FaWald/Project-Voxel/README.md

# Project-Voxel
Some HW &amp; SW Project bundle under this name
