FaWald/Project-Voxel/Modules/Eth2UsbC/BOM.txt

| Type | Name | LCSC Number  | Price (€)  |
|---|---|---|---|
| LAN | CKMTW R-RJ45R08P-C000 | C386757 | 0.3467 |
| ETH-Chip  | REALTEK RTL8153B-VB-CG | C2802072 | 3.1395	 |
