FaWald/Project-Voxel/Modules/Eth2UsbC/Eth2UsbC.kicad_pcb

## KiCad design misc/01_cn_remo_connector.kicad_sch

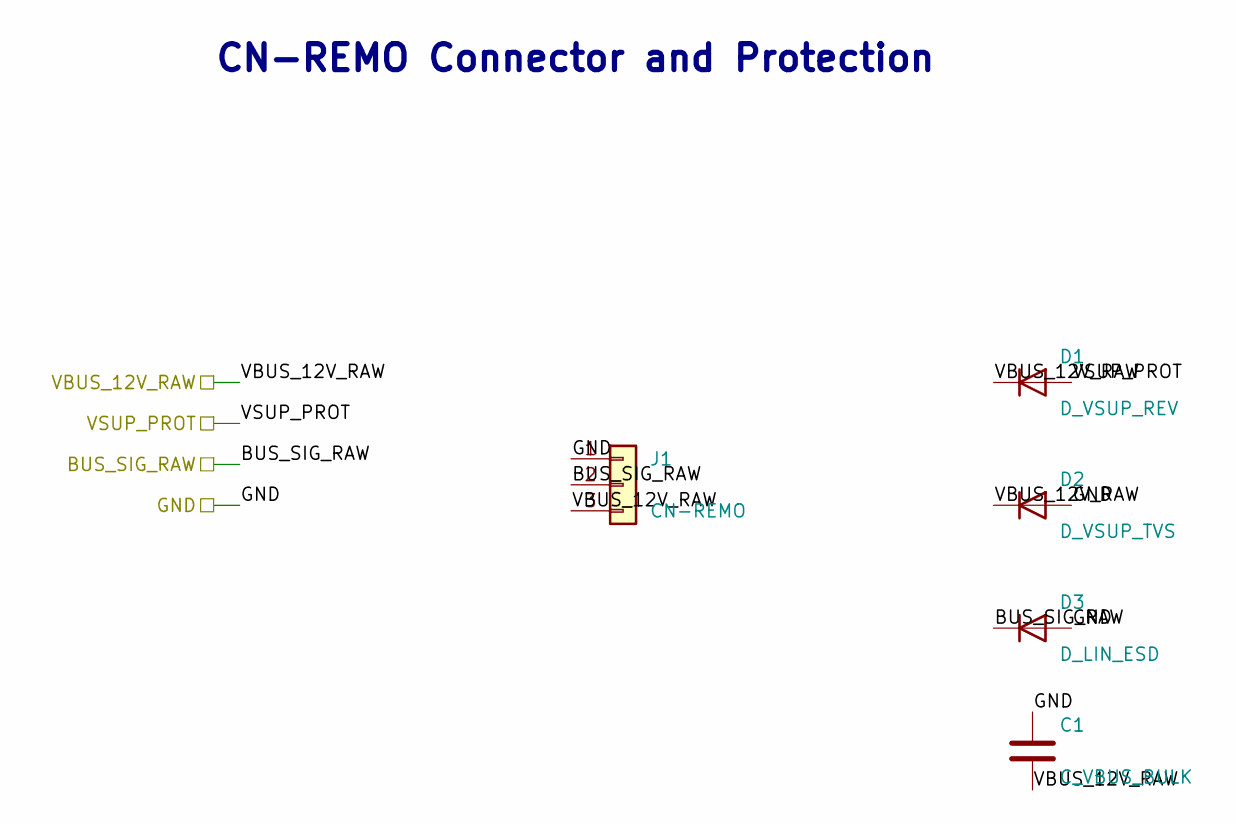
[picture p1: schematic 01_cn_remo_connector.kicad_sch]

Parts:
C1: C_VBUS_BULK
D1: D_VSUP_REV
D2: D_VSUP_TVS
D3: D_LIN_ESD
J1: CN-REMO

Connections:
BUS_SIG_RAW: D3.1 (K), J1.2
GND: C1.1, D2.2 (A), D3.2 (A), J1.1
VBUS_12V_RAW: C1.2, D1.1 (K), D2.1 (K), J1.3
VSUP_PROT: D1.2 (A)

Notes on the sheet:
CN-REMO Connector and Protection
