FaWald/Project-Voxel/Modules/Eth2UsbC/Eth2UsbC.kicad_pcb

## KiCad design misc/02_tlin14313_lin_sbc.kicad_sch

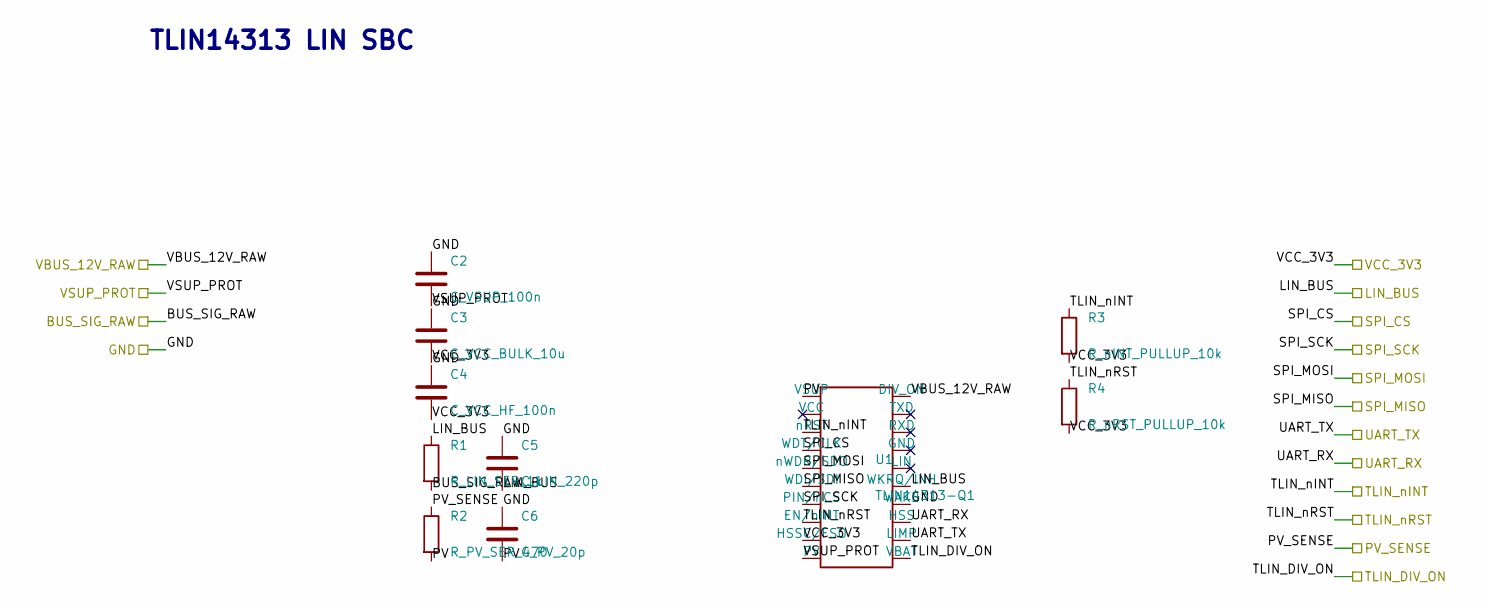
[picture p2: schematic 02_tlin14313_lin_sbc.kicad_sch]

Parts:
C2: C_VSUP_100n
C3: C_VCC_BULK_10u
C4: C_VCC_HF_100n
C5: C_LIN_220p
C6: C_PV_20p
R1: R_LIN_SER_1k
R2: R_PV_SER_470
R3: R_nINT_PULLUP_10k
R4: R_nRST_PULLUP_10k
U1: TLIN14313-Q1

Connections:
BUS_SIG_RAW: R1.2
GND: C2.1, C3.1, C4.1, C5.1, C6.1, U1.17 (WAKE)
LIN_BUS: C5.2, R1.1, U1.16 (WKRQ/INH)
PV: C6.2, R2.2, U1.1 (VSUP)
PV_SENSE: R2.1
SPI_CS: U1.4 (WDT/CLK)
SPI_MISO: U1.6 (WDI/SDI)
SPI_MOSI: U1.5 (nWDR/SDO)
SPI_SCK: U1.7 (PIN/nCS)
TLIN_DIV_ON: U1.20 (VBAT)
TLIN_nINT: R3.1, U1.3 (nRST)
TLIN_nRST: R4.1, U1.8 (EN/nINT)
UART_RX: U1.18 (HSS)
UART_TX: U1.19 (LIMP)
VBUS_12V_RAW: U1.11 (DIV_ON)
VCC_3V3: C3.2, C4.2, R3.2, R4.2, U1.9 (HSSC/FSO)
VSUP_PROT: C2.2, U1.10 (PV)

Notes on the sheet:
TLIN14313 LIN SBC
