FaWald/Project-Voxel/Modules/Eth2UsbC/Eth2UsbC.kicad_pcb

## KiCad design misc/03_nrf54l10_power_reset_clocks.kicad_sch

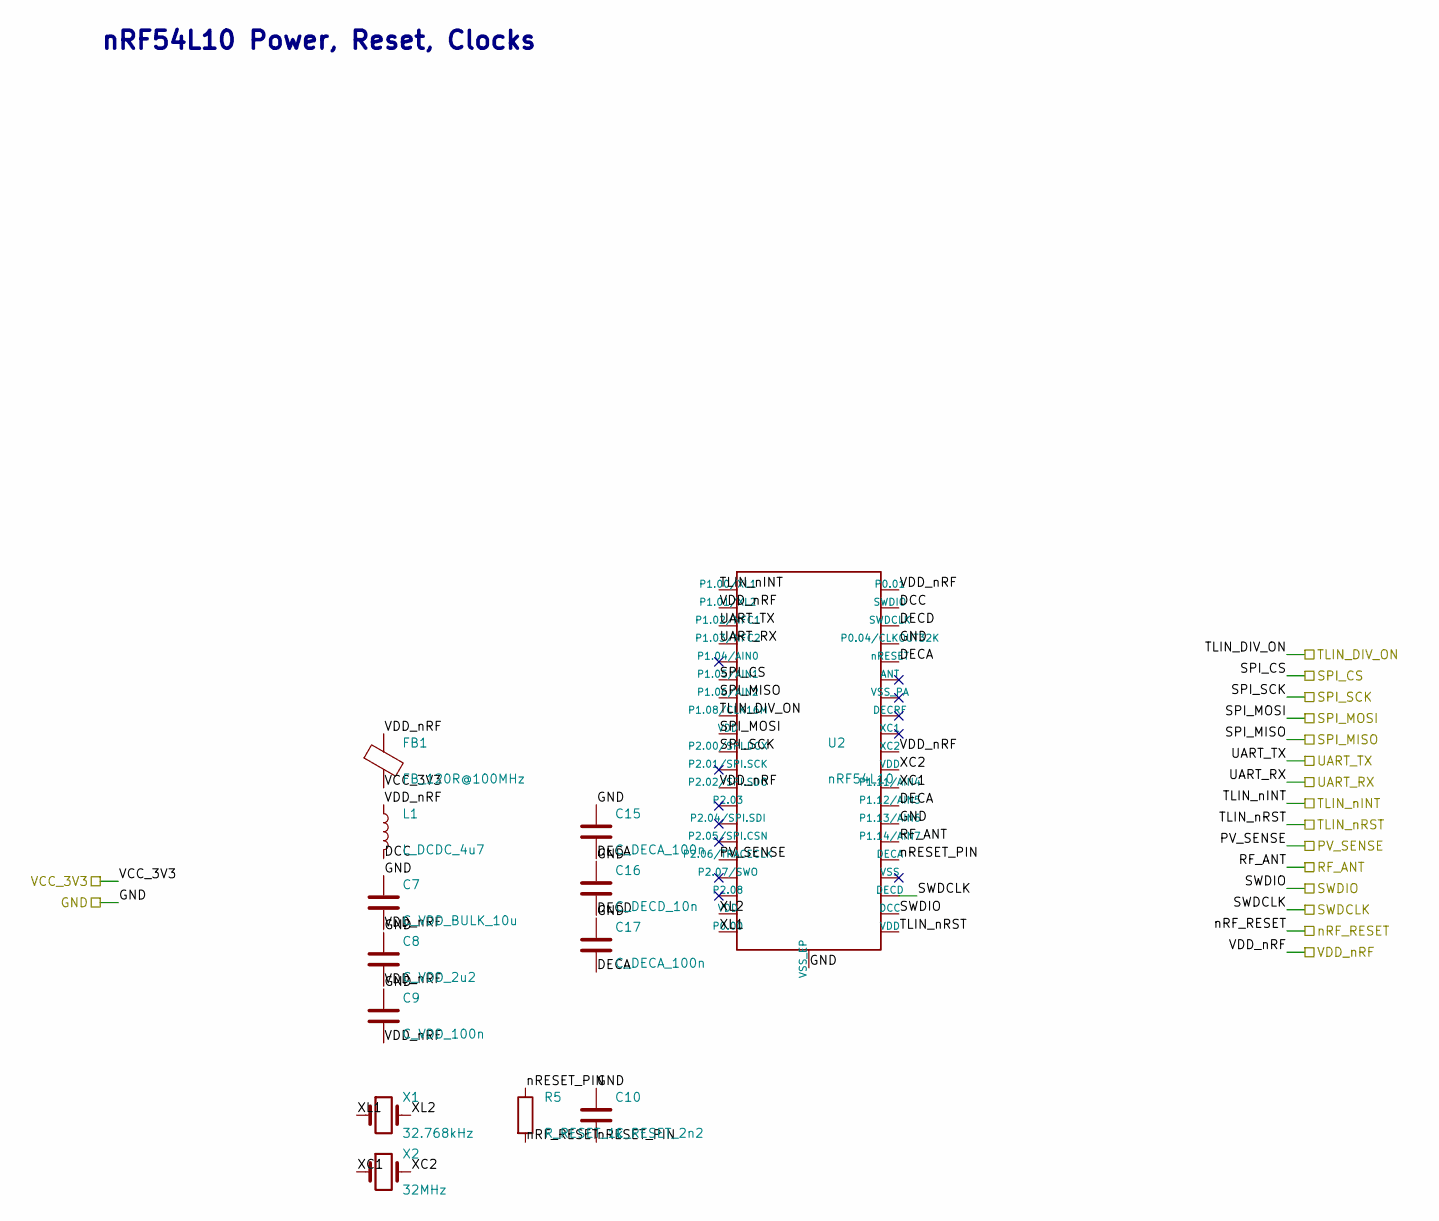
[picture p3: schematic 03_nrf54l10_power_reset_clocks.kicad_sch]

Parts:
C7: C_VDD_BULK_10u
C8: C_VDD_2u2
C9: C_VDD_100n
C10: C_RESET_2n2
C15, C17: C_DECA_100n
C16: C_DECD_10n
FB1: FB_120R@100MHz
L1: L_DCDC_4u7
R5: R_RESET_1k
U2: nRF54L10
X1: 32.768kHz
X2: 32MHz

Connections:
DCC: L1.2, U2.22 (SWDIO)
DECA: C15.2, C17.2, U2.25 (nRESET), U2.33 (P1.12/AIN5)
DECD: C16.2, U2.23 (SWDCLK)
GND: C7.1, C8.1, C9.1, C10.1, C15.1, C16.1, C17.1, U2.24 (P0.04/CLKOUT32K), U2.34 (P1.13/AIN6), U2.41 (VSS_EP)
PV_SENSE: U2.16 (P2.06/TRACECLK)
RF_ANT: U2.35 (P1.14/AIN7)
SPI_CS: U2.6 (P1.05/AIN1)
SPI_MISO: U2.7 (P1.06/AIN2)
SPI_MOSI: U2.9 (VDD)
SPI_SCK: U2.10 (P2.00/SPI.DCX)
SWDCLK: U2.38 (DECD)
SWDIO: U2.39 (DCC)
TLIN_DIV_ON: U2.8 (P1.08/CLK16M)
TLIN_nINT: U2.1 (P1.00/XL1)
TLIN_nRST: U2.40 (VDD)
UART_RX: U2.4 (P1.03/NFC2)
UART_TX: U2.3 (P1.02/NFC1)
VCC_3V3: FB1.2
VDD_nRF: C7.2, C8.2, C9.2, FB1.1, L1.1, U2.2 (P1.01/XL2), U2.12 (P2.02/SPI.SDO), U2.21 (P0.01), U2.30 (XC2)
XC1: U2.32 (P1.11/AIN4), X2.1
XC2: U2.31 (VDD), X2.2
XL1: U2.20 (P0.00), X1.1
XL2: U2.19 (VDD), X1.2
nRESET_PIN: C10.2, R5.1, U2.36 (DECA)
nRF_RESET: R5.2

Notes on the sheet:
nRF54L10 Power, Reset, Clocks
