FaWald/Project-Voxel/Modules/Eth2UsbC/Eth2UsbC.kicad_pcb

## KiCad design misc/04_rf_antenna.kicad_sch

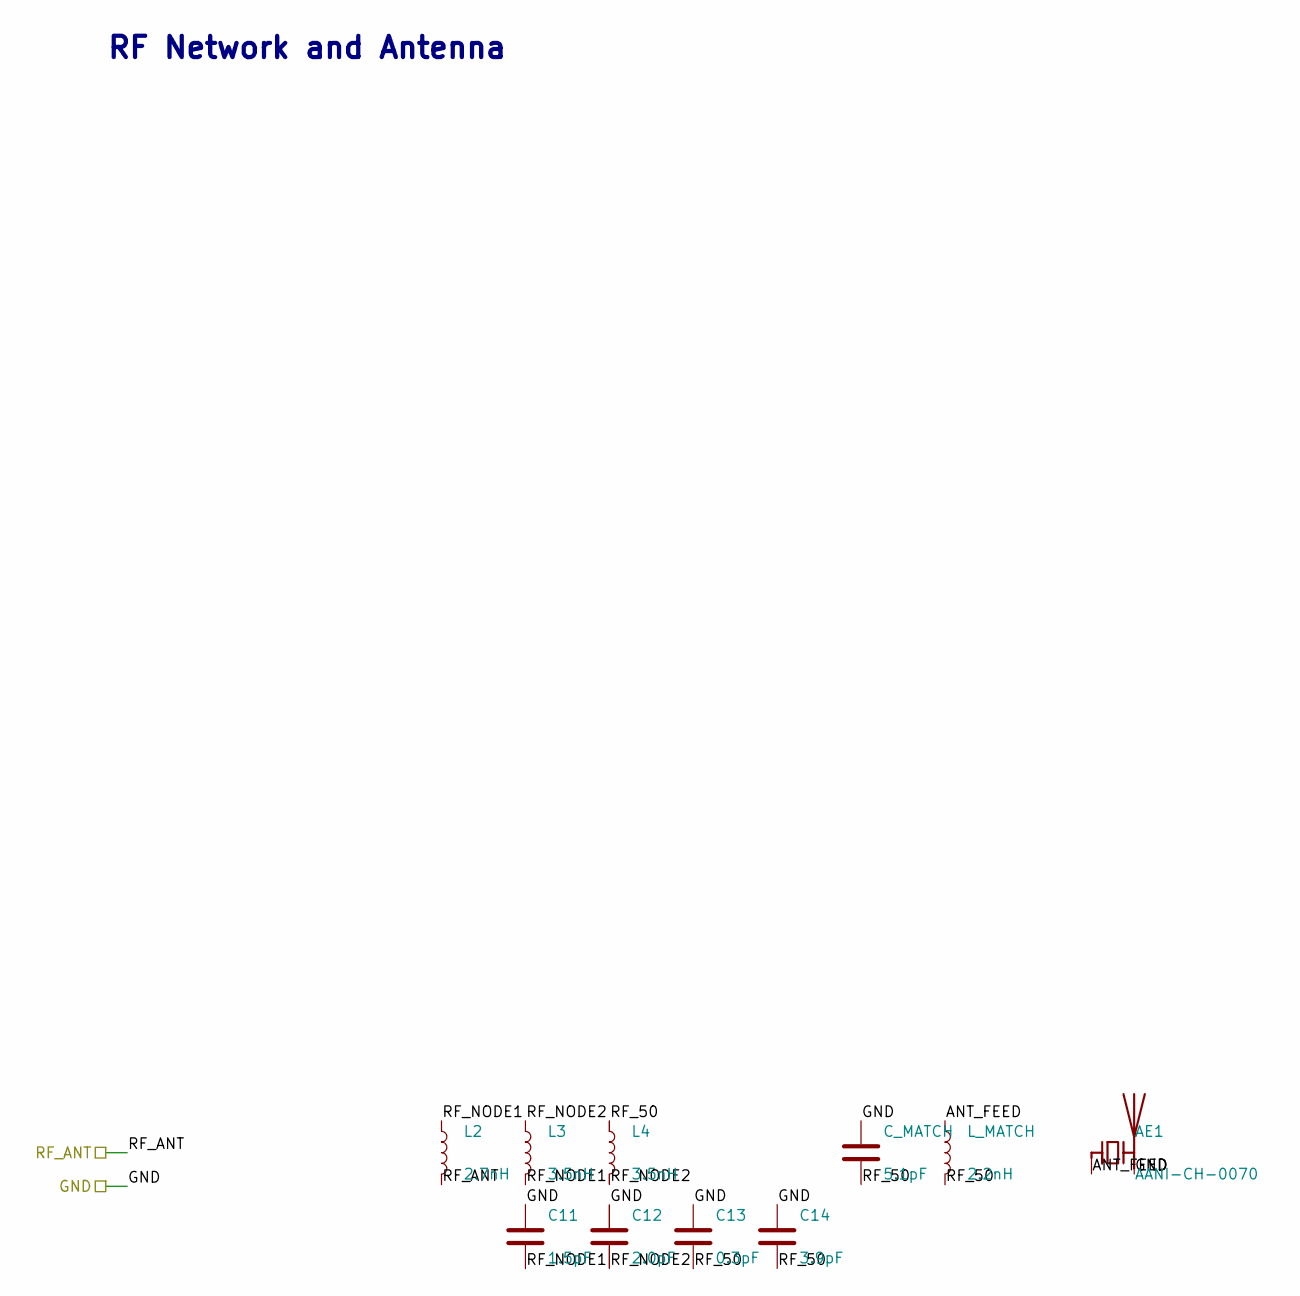
[picture p4: schematic 04_rf_antenna.kicad_sch]

Parts:
AE1: AANI-CH-0070
C11: 1.5pF
C12: 2.0pF
C13: 0.3pF
C14: 3.9pF
C_MATCH: 5.1pF
L2: 2.7nH
L3, L4: 3.5nH
L_MATCH: 2.2nH

Connections:
ANT_FEED: AE1.1 (FEED), L_MATCH.1
GND: AE1.2 (PCB_Trace), C11.1, C12.1, C13.1, C14.1, C_MATCH.1
RF_50: C13.2, C14.2, C_MATCH.2, L4.1, L_MATCH.2
RF_ANT: L2.2
RF_NODE1: C11.2, L2.1, L3.2
RF_NODE2: C12.2, L3.1, L4.2

Notes on the sheet:
RF Network and Antenna
