FaWald/Project-Voxel/Modules/Eth2UsbC/Eth2UsbC.kicad_pcb

## KiCad design misc/05_debug_test.kicad_sch

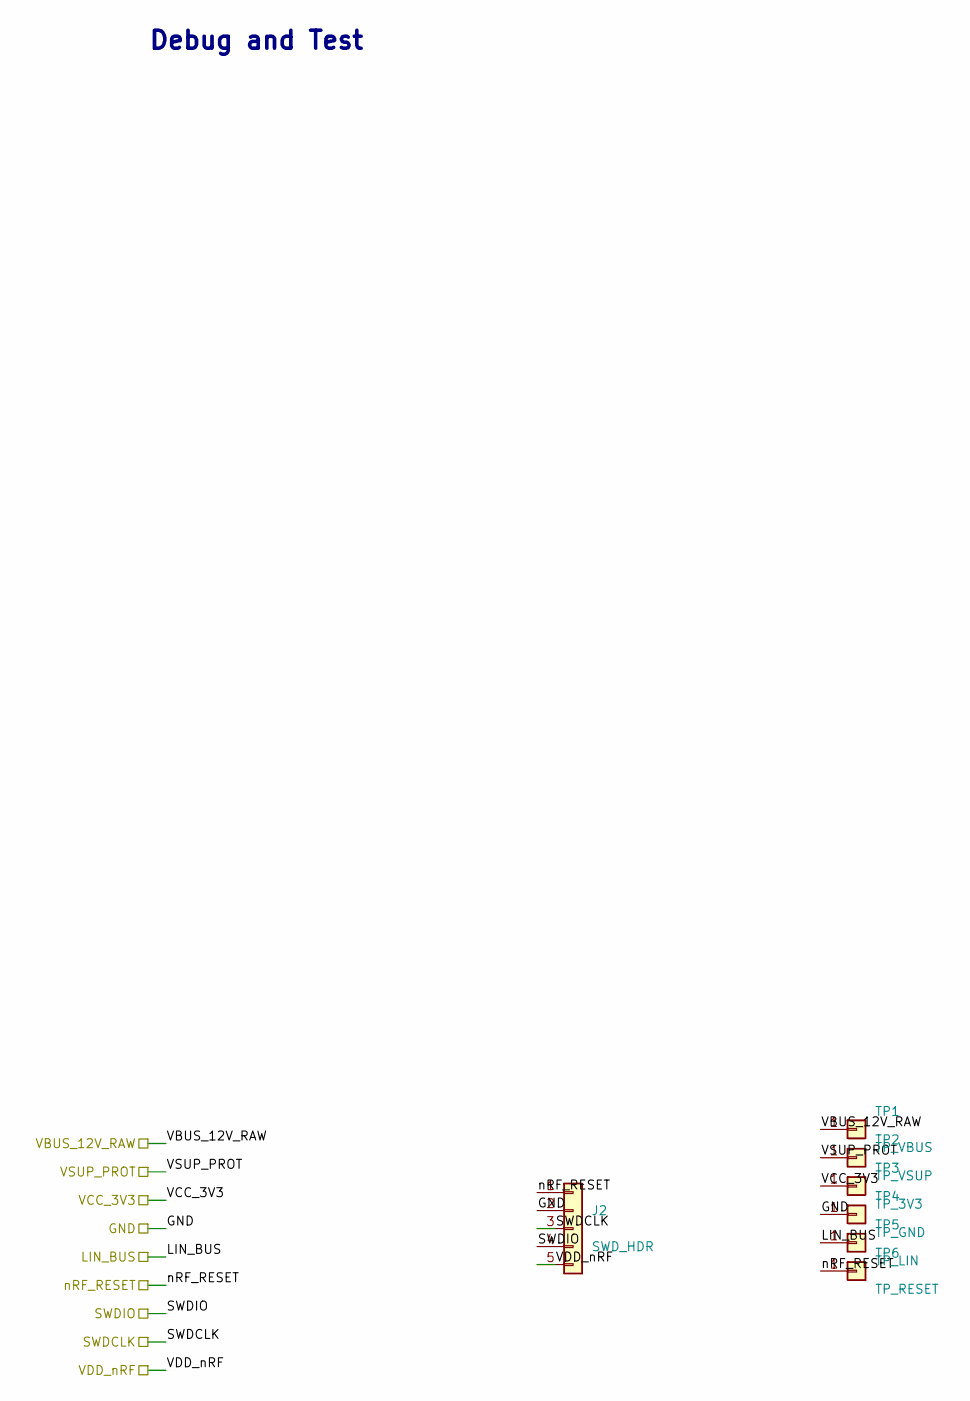
[picture p5: schematic 05_debug_test.kicad_sch]

Parts:
J2: SWD_HDR
TP1: TP_VBUS
TP2: TP_VSUP
TP3: TP_3V3
TP4: TP_GND
TP5: TP_LIN
TP6: TP_RESET

Connections:
GND: J2.2, TP4.1
LIN_BUS: TP5.1
SWDCLK: J2.3
SWDIO: J2.4
VBUS_12V_RAW: TP1.1
VCC_3V3: TP3.1
VDD_nRF: J2.5
VSUP_PROT: TP2.1
nRF_RESET: J2.1, TP6.1

Notes on the sheet:
Debug and Test
