FaWald/Project-Voxel/Modules/Eth2UsbC/Eth2UsbC.kicad_pcb

## KiCad design misc/backup.kicad_sch

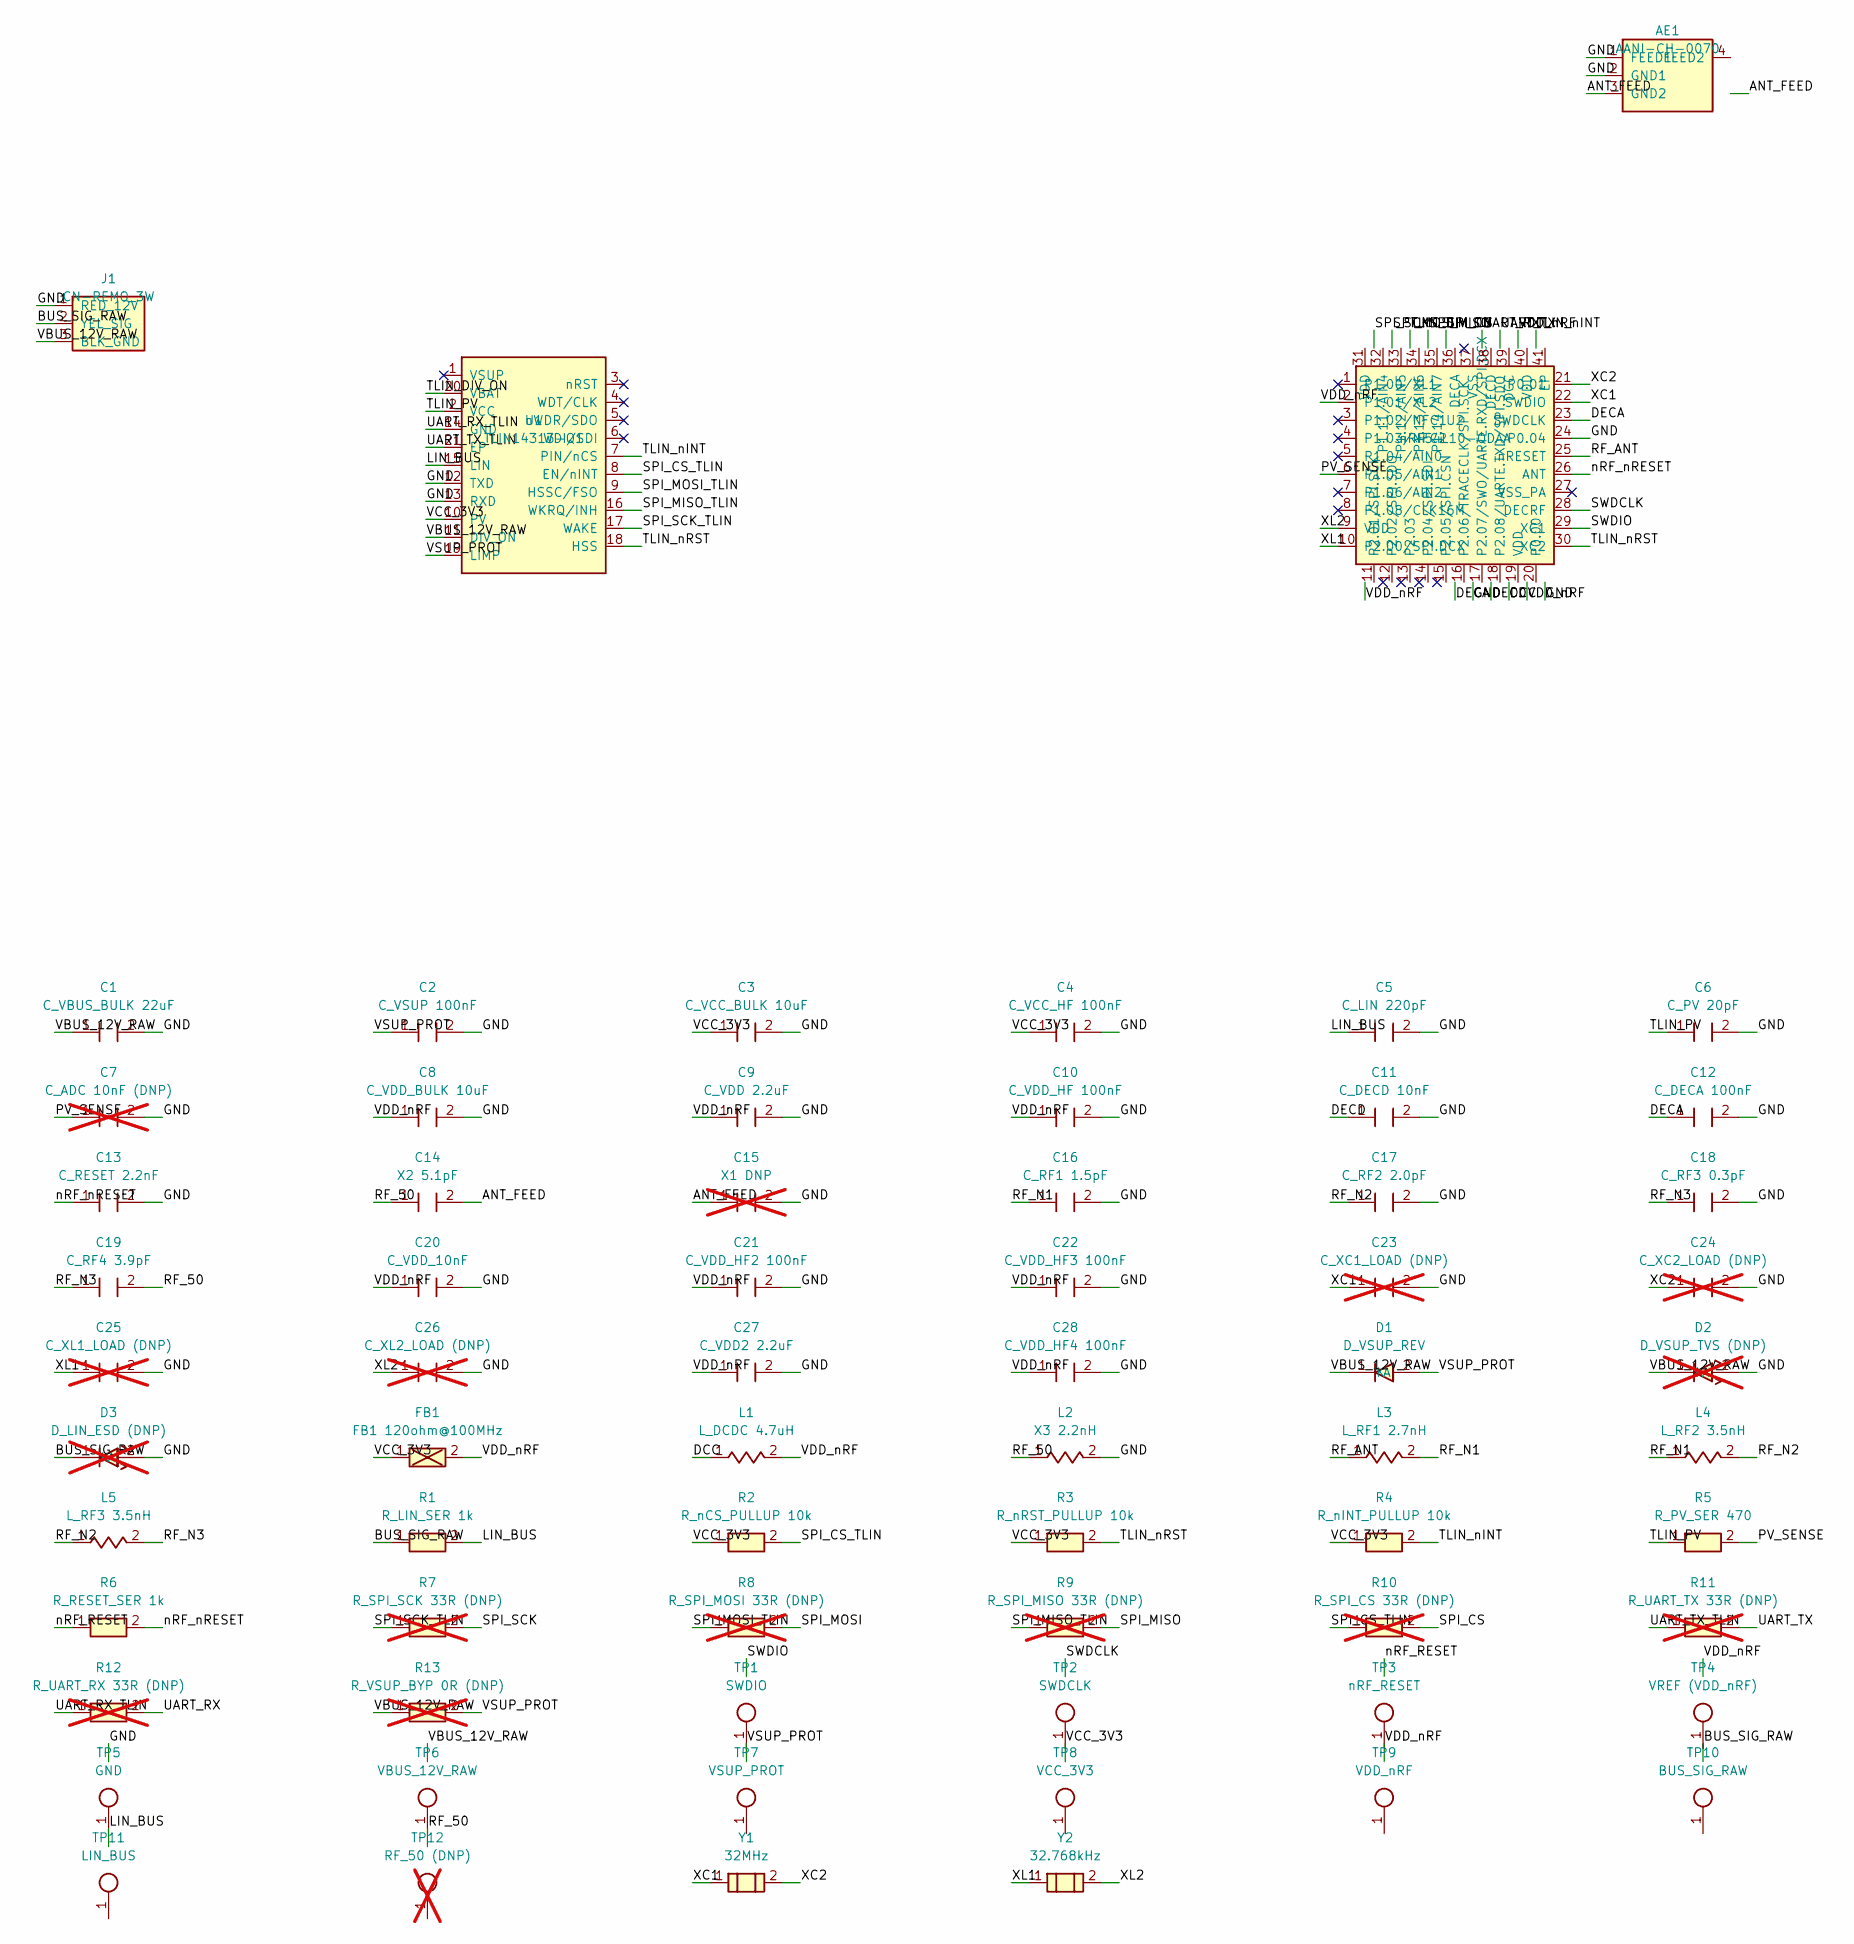
[picture p6: schematic backup.kicad_sch]

Parts:
AE1: AANI-CH-0070; Abracon_AANI-CH-0070
C1: C_VBUS_BULK 22uF; C_0805_2012Metric
C2: C_VSUP 100nF; C_0402_1005Metric
C3: C_VCC_BULK 10uF; C_0603_1608Metric
C4: C_VCC_HF 100nF; C_0402_1005Metric
C5: C_LIN 220pF; C_0402_1005Metric
C6: C_PV 20pF; C_0402_1005Metric
C7: C_ADC 10nF (DNP); C_0402_1005Metric; not fitted
C8: C_VDD_BULK 10uF; C_0603_1608Metric
C9: C_VDD 2.2uF; C_0402_1005Metric
C10: C_VDD_HF 100nF; C_0402_1005Metric
C11: C_DECD 10nF; C_0402_1005Metric
C12: C_DECA 100nF; C_0402_1005Metric
C13: C_RESET 2.2nF; C_0402_1005Metric
C14: X2 5.1pF; C_0402_1005Metric
C15: X1 DNP; C_0402_1005Metric; not fitted
C16: C_RF1 1.5pF; C_0402_1005Metric
C17: C_RF2 2.0pF; C_0402_1005Metric
C18: C_RF3 0.3pF; C_0402_1005Metric
C19: C_RF4 3.9pF; C_0402_1005Metric
C20: C_VDD_10nF; C_0402_1005Metric
C21: C_VDD_HF2 100nF; C_0402_1005Metric
C22: C_VDD_HF3 100nF; C_0402_1005Metric
C23: C_XC1_LOAD (DNP); C_0402_1005Metric; not fitted
C24: C_XC2_LOAD (DNP); C_0402_1005Metric; not fitted
C25: C_XL1_LOAD (DNP); C_0402_1005Metric; not fitted
C26: C_XL2_LOAD (DNP); C_0402_1005Metric; not fitted
C27: C_VDD2 2.2uF; C_0402_1005Metric
C28: C_VDD_HF4 100nF; C_0402_1005Metric
D1: D_VSUP_REV; D_SMA
D2: D_VSUP_TVS (DNP); D_SMB; not fitted
D3: D_LIN_ESD (DNP); D_SOD-523; not fitted
FB1: FB1 120ohm@100MHz; Ferrite_Bead_0603_1608Metric
J1: CN-REMO_3W
L1: L_DCDC 4.7uH; L_0603_1608Metric
L2: X3 2.2nH; L_0402_1005Metric
L3: L_RF1 2.7nH; L_0402_1005Metric
L4: L_RF2 3.5nH; L_0402_1005Metric
L5: L_RF3 3.5nH; L_0402_1005Metric
R1: R_LIN_SER 1k; R_0402_1005Metric
R2: R_nCS_PULLUP 10k; R_0402_1005Metric
R3: R_nRST_PULLUP 10k; R_0402_1005Metric
R4: R_nINT_PULLUP 10k; R_0402_1005Metric
R5: R_PV_SER 470; R_0402_1005Metric
R6: R_RESET_SER 1k; R_0402_1005Metric
R7: R_SPI_SCK 33R (DNP); R_0402_1005Metric; not fitted
R8: R_SPI_MOSI 33R (DNP); R_0402_1005Metric; not fitted
R9: R_SPI_MISO 33R (DNP); R_0402_1005Metric; not fitted
R10: R_SPI_CS 33R (DNP); R_0402_1005Metric; not fitted
R11: R_UART_TX 33R (DNP); R_0402_1005Metric; not fitted
R12: R_UART_RX 33R (DNP); R_0402_1005Metric; not fitted
R13: R_VSUP_BYP 0R (DNP); R_0603_1608Metric; not fitted
TP1: SWDIO; TestPoint_Pad_D1.0mm
TP2: SWDCLK; TestPoint_Pad_D1.0mm
TP3: nRF_RESET; TestPoint_Pad_D1.0mm
TP4: VREF (VDD_nRF); TestPoint_Pad_D1.0mm
TP5: GND; TestPoint_Pad_D1.0mm
TP6: VBUS_12V_RAW; TestPoint_Pad_D1.0mm
TP7: VSUP_PROT; TestPoint_Pad_D1.0mm
TP8: VCC_3V3; TestPoint_Pad_D1.0mm
TP9: VDD_nRF; TestPoint_Pad_D1.0mm
TP10: BUS_SIG_RAW; TestPoint_Pad_D1.0mm
TP11: LIN_BUS; TestPoint_Pad_D1.0mm
TP12: RF_50 (DNP); TestPoint_Pad_D1.0mm; not fitted
U1: TLIN14313-Q1; VQFN-20-1EP_4.5x3.5mm_P0.5mm
U2: nRF54L10-QDAA; QFN-40-1EP_5x5mm_P0.4mm
Y1: 32MHz; Crystal_SMD_2016-2Pin_2.0x1.6mm
Y2: 32.768kHz; Crystal_SMD_2012-2Pin_2.0x1.2mm

Connections:
ANT_FEED: AE1.3 (GND2), C14.2, C15.1
BUS_SIG_RAW: D3.1 (A), J1.2 (YEL_SIG), R1.1
DCC: L1.1
DECA: C12.1, U2.23 (SWDCLK)
DECD: C11.1
GND: AE1.1 (FEED1), AE1.2 (GND1), C1.2, C2.2, C3.2, C4.2, C5.2, C6.2, C7.2, C8.2, C9.2, C10.2, C11.2, C12.2, C13.2, C15.2, C16.2, C17.2, C18.2, C20.2, C21.2, C22.2, C23.2, C24.2, C25.2, C26.2, C27.2, C28.2, D2.2 (K), D3.2 (K), J1.1 (RED_12V), L2.2, U1.12 (TXD), U1.13 (RXD), U2.24 (P0.04)
LIN_BUS: C5.1, R1.2, U1.15 (LIN)
PV_SENSE: C7.1, R5.2, U2.6 (P1.05/AIN1)
RF_50: C14.1, C19.2, L2.1
RF_ANT: L3.1, U2.25 (nRESET)
RF_N1: C16.1, L3.2, L4.1
RF_N2: C17.1, L4.2, L5.1
RF_N3: C18.1, C19.1, L5.2
SPI_CS: R10.2
SPI_CS_TLIN: R2.2, R10.1, U1.8 (EN/nINT)
SPI_MISO: R9.2
SPI_MISO_TLIN: R9.1, U1.16 (WKRQ/INH)
SPI_MOSI: R8.2
SPI_MOSI_TLIN: R8.1, U1.9 (HSSC/FSO)
SPI_SCK: R7.2
SPI_SCK_TLIN: R7.1, U1.17 (WAKE)
SWDCLK: U2.28 (DECRF)
SWDIO: U2.29 (XC1)
TLIN_DIV_ON: U1.20 (VBAT)
TLIN_PV: C6.1, R5.1, U1.2 (VCC)
TLIN_nINT: R4.2, U1.7 (PIN/nCS)
TLIN_nRST: R3.2, U1.18 (HSS), U2.30 (XC2)
UART_RX: R12.2
UART_RX_TLIN: R12.1, U1.14 (GND)
UART_TX: R11.2
UART_TX_TLIN: R11.1, U1.21 (EP)
VBUS_12V_RAW: C1.1, D1.1 (A), D2.1 (A), J1.3 (BLK_GND), R13.1, U1.11 (DIV_ON)
VCC_3V3: C3.1, C4.1, FB1.1, R2.1, R3.1, R4.1, U1.10 (PV)
VDD_nRF: C8.1, C9.1, C10.1, C20.1, C21.1, C22.1, C27.1, C28.1, FB1.2, L1.2, U2.2 (P1.01/XL2)
VSUP_PROT: C2.1, D1.2 (K), R13.2, U1.19 (LIMP)
XC1: C23.1, U2.22 (SWDIO), Y1.1
XC2: C24.1, U2.21 (P0.01), Y1.2
XL1: C25.1, U2.10 (P2.00/SPI.DCX), Y2.1
XL2: C26.1, U2.9 (VDD), Y2.2
nRF_RESET: R6.1
nRF_nRESET: C13.1, R6.2, U2.26 (ANT)
