FaWald/Project-Voxel/Modules/Eth2UsbC/Eth2UsbC.kicad_pcb

## KiCad design misc/iso_test.kicad_sch

Schematic: iso_test.kicad_sch

Parts:
AE1: AANI-CH-0070; Abracon_AANI-CH-0070
C28: C_VDD_HF4 100nF; C_0402_1005Metric
D1: D_VSUP_REV; D_SMA
D2: D_VSUP_TVS (DNP); D_SMB; not fitted
D3: D_LIN_ESD (DNP); D_SOD-523; not fitted
J1: CN-REMO_3W
U1: TLIN14313-Q1; VQFN-20-1EP_4.5x3.5mm_P0.5mm
U2: nRF54L10-QDAA; QFN-40-1EP_5x5mm_P0.4mm
