FaWald/Project-Voxel/(commit log)

2025-10-25 Created first module and added library
    [1-281740-2.stp, 1.25T-2AWTP(MOLEX_53261-0271).step, 10118194.step, 1871916-1.stp, 20-pin_SMT_header.STEP, 20PinMaleSmt.stp, 29658.stp, 40PinMaleSMD.stp]
2025-10-25 Add OLIMEX KiCAD libs as submodule (track master)
2025-10-25 some changes
    [1-281740-2.stp, 1.25T-2AWTP(MOLEX_53261-0271).step, 10118194.step, 1871916-1.stp, 20-pin_SMT_header.STEP, 20PinMaleSmt.stp, 29658.stp, 40PinMaleSMD.stp]
